IllinoisRoboticsInSpace/IRIS-PCB/IRIS-7/High Power Buck Converter/High Power Buck Converter.kicad_pcb

## KiCad design IRIS-7/High Power Buck Converter/High Power Buck Converter.kicad_pcb (2017-04-25)

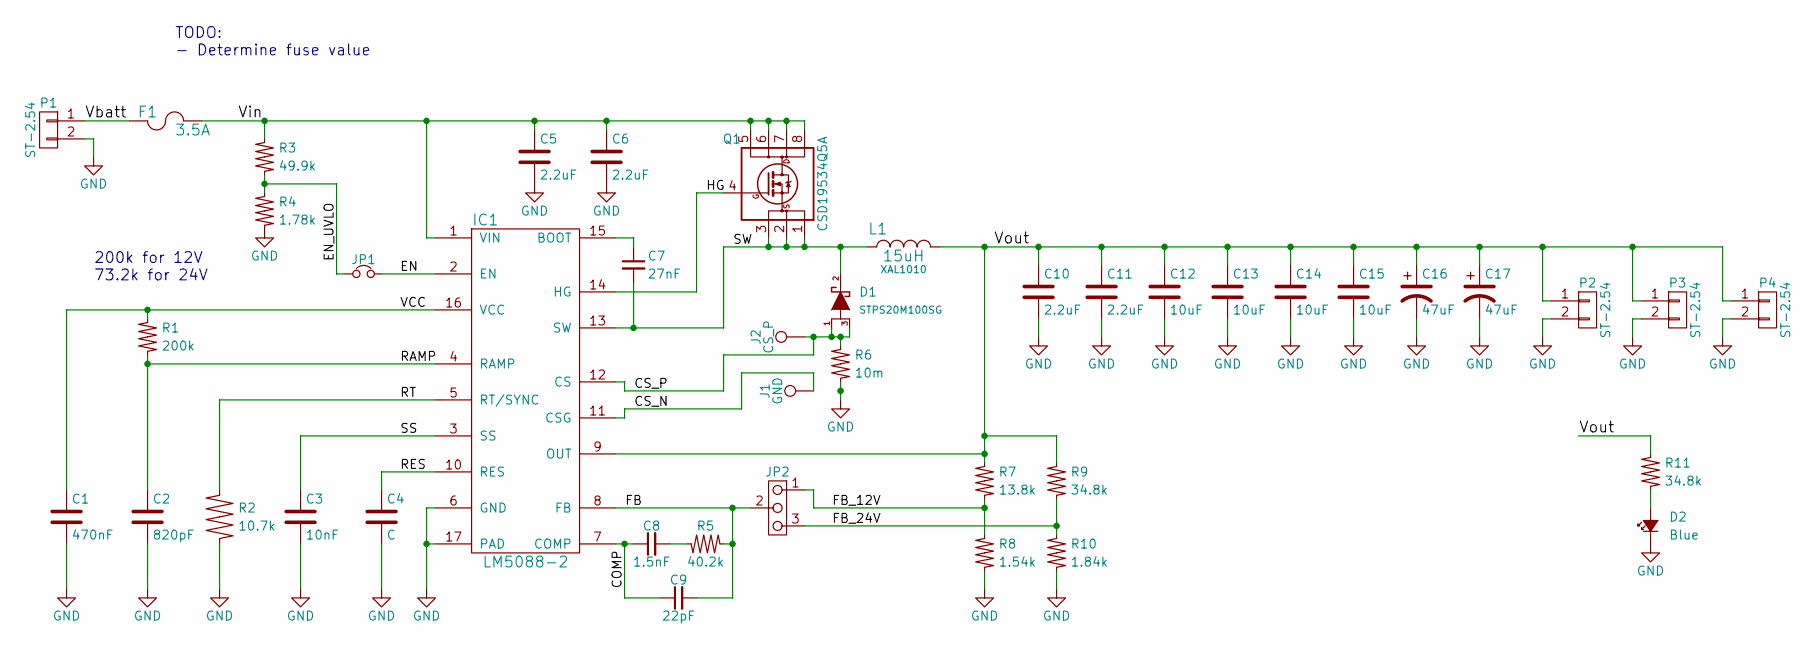
[picture p1: schematic High Power Buck Converter.sch, Selectable 12V/24V Buck Converter]

Parts:
C1: 470nF; C_0805
C2: 820pF; C_0805
C3: 10nF; C_0805
C4: C; C_0805
C5, C6, C10, C11: 2.2uF; C_1210
C7: 27nF; C_0805
C8: 1.5nF; C_0805
C9: 22pF; C_0805
C12, C13, C14, C15: 10uF; C_1206
C16, C17: 47uF; CP_Elec_8x10.5
D1: STPS20M100SG; TO-263-3Lead
D2: Blue; LED_0805
F1: 3.5A; Fuseholder5x20_horiz_open_Schurter_0031_8201
IC1: LM5088-2; HTSSOP-16_EP
J1: GND; SMD_0.3
J2: CS_P; SMD_0.3
JP1: JP_NC; Pin_Header_Straight_1x02_Pitch2.54mm
JP2: JP-3_R; Pin_Header_Straight_1x03_Pitch2.54mm
L1: 15uH; XAL1010
P1, P2, P3, P4: ST-2.54; TerminalBlock_Pheonix_MKDS1.5-2pol
Q1: CSD19534Q5A; TDSON-8-1
R1: 200k; R_0805
R2: 10.7k; R_0805
R3: 49.9k; R_0805
R4: 1.78k; R_0805
R5: 40.2k; R_0805
R6: 10m; R_2010
R7: 13.8k; R_0805
R8: 1.54k; R_0805
R9, R11: 34.8k; R_0805
R10: 1.84k; R_0805

Connections:
/COMP: C8.1, C9.1, IC1.7 (COMP)
/CS_N: IC1.11 (CSG), J1.1
/CS_P: D1.1 (A), D1.3 (A), IC1.12 (CS), J2.1, R6.2
/EN: IC1.2 (EN), JP1.2
/EN_UVLO: JP1.1, R3.1, R4.2
/FB: C9.2, IC1.8 (FB), JP2.2, R5.1
/FB_12V: JP2.1, R7.1, R8.2
/FB_24V: JP2.3, R9.1, R10.2
/HG: IC1.14 (HG), Q1.4 (G)
/RAMP: C2.1, IC1.4 (RAMP), R1.1
/RES: C4.1, IC1.10 (RES)
/RT: IC1.5 (RT/SYNC), R2.2
/SS: C3.1, IC1.3 (SS)
/SW: C7.2, D1.2 (K), IC1.13 (SW), L1.1, Q1.1 (S), Q1.2 (S), Q1.3 (S)
/VCC: C1.1, IC1.16 (VCC), R1.2
/Vbatt: F1.1, P1.1
/Vin: C5.1, C6.1, F1.2, IC1.1 (VIN), Q1.5 (D), Q1.6 (D), Q1.7 (D), Q1.8 (D), R3.2
/Vout: C10.1, C11.1, C12.1, C13.1, C14.1, C15.1, C16.1, C17.1, IC1.9 (OUT), L1.2, P2.1, P3.1, P4.1, R7.2, R9.2, R11.2
GND: C1.2, C2.2, C3.2, C4.2, C5.2, C6.2, C10.2, C11.2, C12.2, C13.2, C14.2, C15.2, C16.2, C17.2, D2.1 (K), IC1.6 (GND), IC1.17 (PAD), P1.2, P2.2, P3.2, P4.2, R2.1, R4.1, R6.1, R8.1, R10.1
unnamed: C7.1, IC1.15 (BOOT)
unnamed: C8.2, R5.2
unnamed: D2.2 (A), R11.1

Notes on the sheet:
200k for 12V 73.2k for 24V
TODO: - Determine fuse value

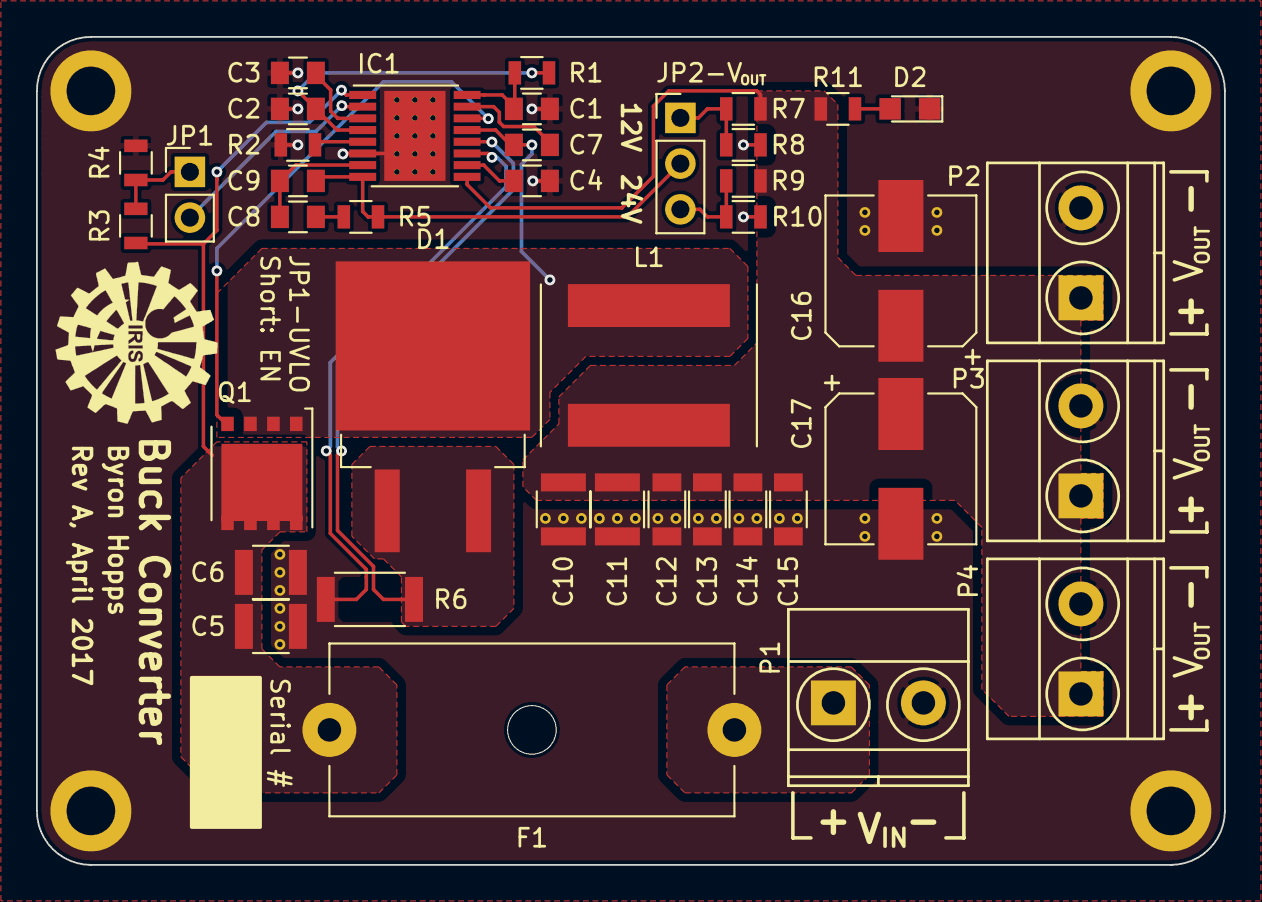
[picture p2: board High Power Buck Converter.kicad_pcb from above]

Board: 2 copper layers, 66.0 x 46.0 mm, 41 parts (0 on the bottom side), 21 nets.
