IllinoisRoboticsInSpace/IRIS-PCB/(commit log)

2017-03-07 Add submodule for schematic symbol libraries
2017-04-20 Initial commit for high power buck converter
    [High Power Buck Converter.sch]
2017-04-21 Begin assiging footprints to schematic symbols
    [High Power Buck Converter.sch]
2017-04-21 Created footprint for main inductor
2017-04-21 Begin footprint for LM5088-2
2017-04-22 Finish assigning part footprints
    [High Power Buck Converter.sch]
2017-04-22 Begin component placement
    [High Power Buck Converter.kicad_pcb, High Power Buck Converter.sch]
2017-04-24 Add gerber files to gitignore
2017-04-24 Update power routing
    [High Power Buck Converter.kicad_pcb, High Power Buck Converter.sch]
2017-04-25 Finish layout and final tweaks
    [High Power Buck Converter.kicad_pcb, High Power Buck Converter.sch]
